mnruecke/currentSensing/PCB_layout.png

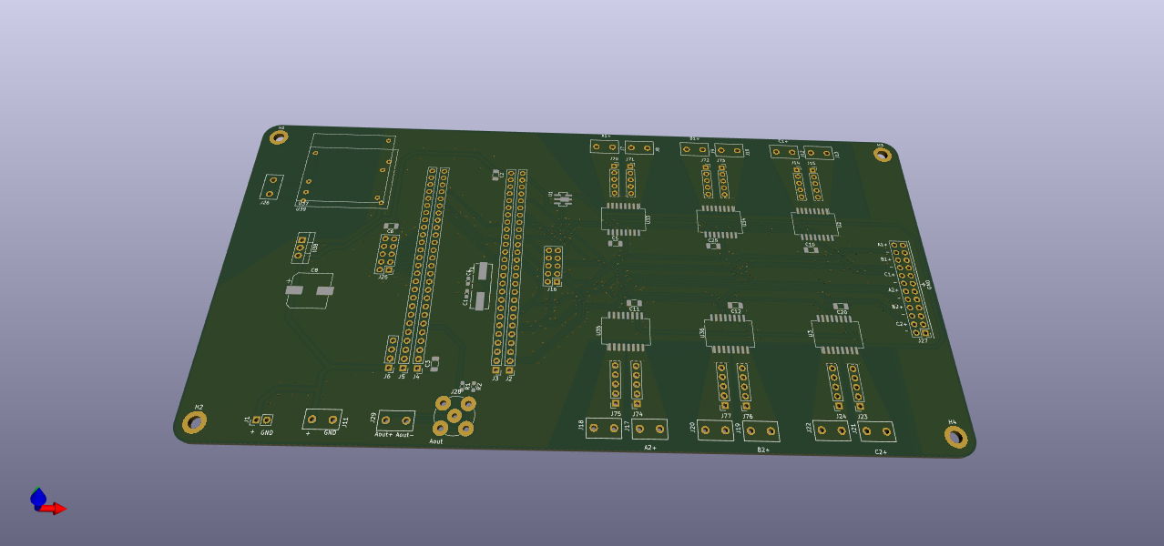
PCB_layout.png
