mnruecke/currentSensing/psoc_directives.png

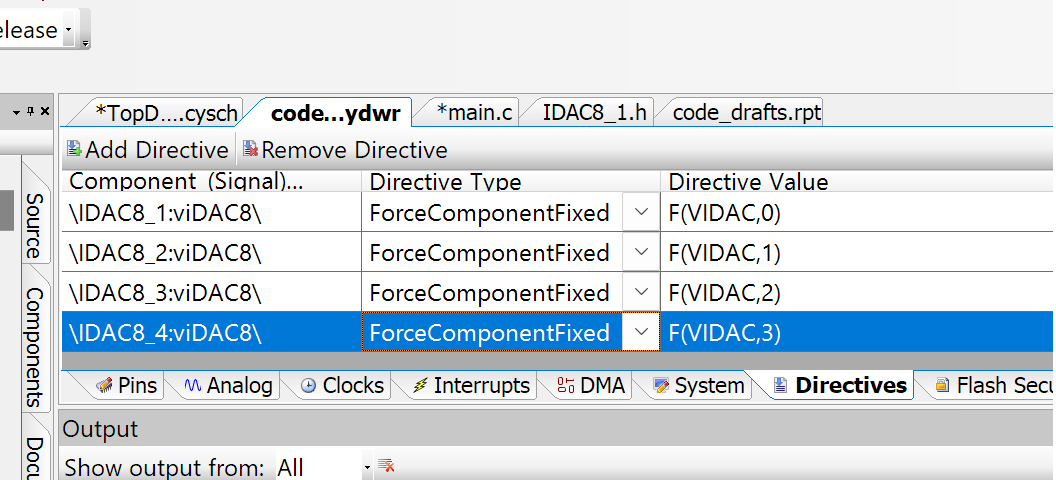
psoc_directives.png
