mnruecke/currentSensing/firmware_schematic_currentSensing_USBFS_ISR.pdf

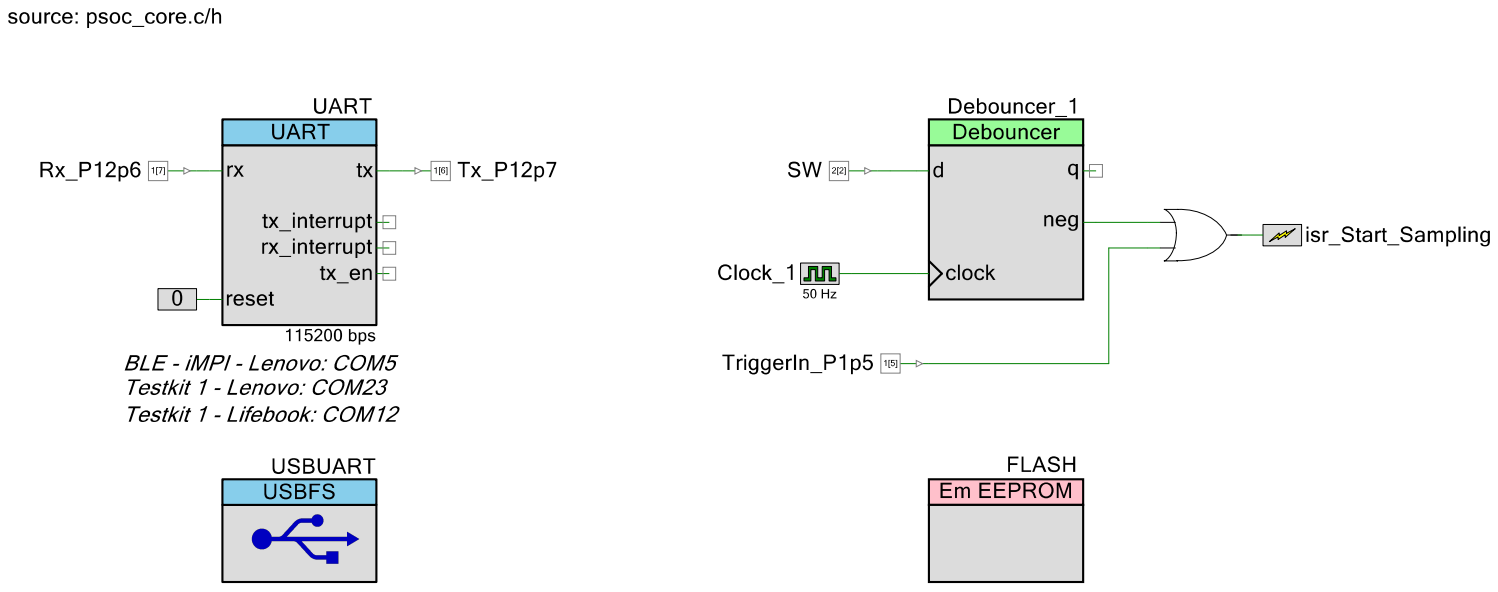
[picture p3: page 2]

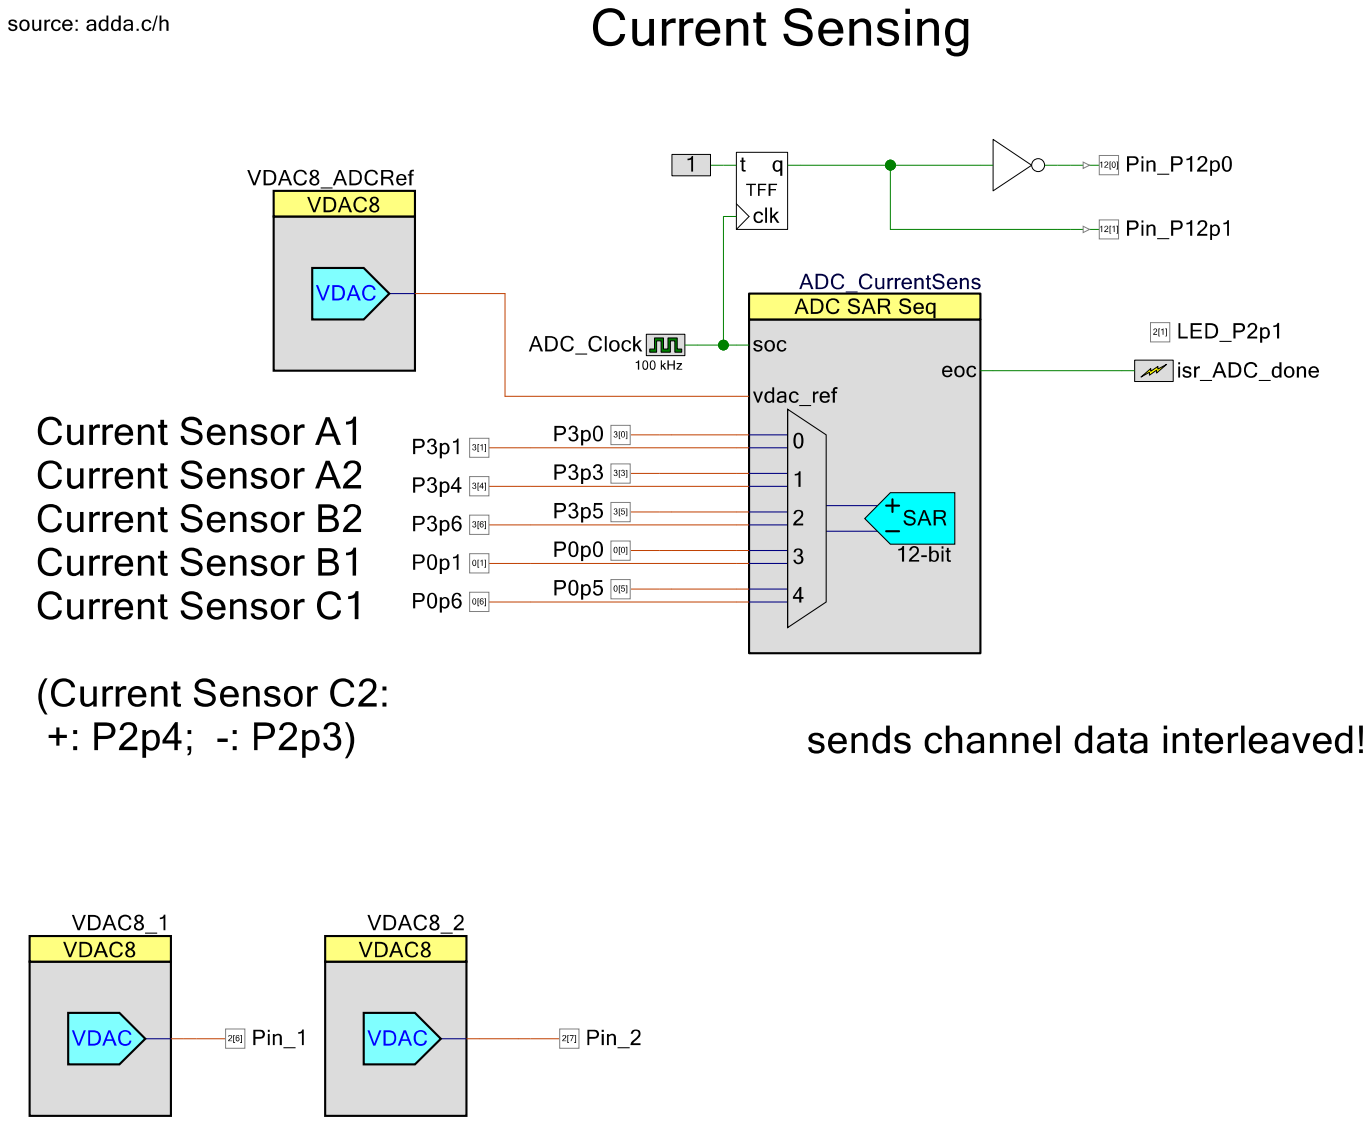
[picture p4: page 3]
