mnruecke/currentSensing/KiCAD_PCB_files/rds_tx.kicad_pcb

## KiCad design KiCAD_PCB_files/rds_tx.kicad_pcb (2023-02-15)

Schematic: rds_tx.kicad_sch, 6CH Current Sensing Module

Parts:
C1, C4: 18p; C_0603_1608Metric_Pad1.08x0.95mm_HandSolder
C2, C3, C5, C6, C10, C11, C12, C20, C25: 100n; C_1206_3216Metric
C8: 100u; CP_Elec_10x12.5
H1, H2, H3, H4: Mounting; MountingHole_3.2mm_M3_DIN965_Pad
J1: LiPo_Akku; PinHeader_1x02_P2.54mm_Vertical
J2: board space lhs; PinHeader_1x26_P2.54mm_Vertical
J3: PSoC lhs; PinHeader_1x26_P2.54mm_Vertical
J4: PSoC rhs; PinHeader_1x26_P2.54mm_Vertical
J5: board space rhs; PinHeader_1x26_P2.54mm_Vertical
J6: BLE; PinHeader_1x04_P2.54mm_Vertical
J7: IP_A1; screw_conn_2
J8: IN_A1; screw_conn_2
J9: IP_B1; screw_conn_2
J10: IN_B1; screw_conn_2
J11: LiPo_Akku; screw_conn_2
J12: IP_C1; screw_conn_2
J13: IN_C1; screw_conn_2
J14: IP_Adjust_C1; PinSocket_1x05_P2.54mm_Vertical
J15: IN_Adjust_C1; PinSocket_1x05_P2.54mm_Vertical
J16: CurrentSensing; PinHeader_2x05_P2.54mm_Vertical
J17: IP_A2; screw_conn_2
J18: IN_A2; screw_conn_2
J19: IP_B2; screw_conn_2
J20: IN_B2; screw_conn_2
J21: IP_C2; screw_conn_2
J22: IN_C2; screw_conn_2
J23: IP_Adjust_C2; PinSocket_1x05_P2.54mm_Vertical
J24: IN_Adjust_C2; PinSocket_1x05_P2.54mm_Vertical
J25: GPIO_Block; PinHeader_2x05_P2.54mm_Vertical
J26: PWR_230V; screw_conn_2
J27: 6CH_Sense; PinHeader_2x12_P2.54mm_Vertical
J28: ACombi; BNC_TEConnectivity_1478204_Vertical
J29: ACombi; screw_conn_2
J70: IP_Adjust_A1; PinSocket_1x05_P2.54mm_Vertical
J71: IN_Adjust_A1; PinSocket_1x05_P2.54mm_Vertical
J72: IP_Adjust_B1; PinSocket_1x05_P2.54mm_Vertical
J73: IN_Adjust_B1; PinSocket_1x05_P2.54mm_Vertical
J74: IP_Adjust_A2; PinSocket_1x05_P2.54mm_Vertical
J75: IN_Adjust_A2; PinSocket_1x05_P2.54mm_Vertical
J76: IP_Adjust_B2; PinSocket_1x05_P2.54mm_Vertical
J77: IN_Adjust_B2; PinSocket_1x05_P2.54mm_Vertical
R1, R2: 0; R_0603_1608Metric_Pad0.98x0.95mm_HandSolder
U1: XC6227; LDO_3p3V_XC6227
U2, U3, U33, U34, U35, U36: MCA1101; SOIC-16W_7.5x12.8mm_P1.27mm
U37: ECE5
U38: L7805; TO-220-3_Vertical
U39: RAC03; ACDC_RAC03
Y1: 18 MHz; ABLS_Crystal_18MHz_SMD

Connections:
+5V: C2.1, C3.1, C6.1, C8.1, J1.1, J2.26, J3.26, J4.1, J5.1, J6.1, J11.1, J16.9, J25.9, U1.1 (CE), U1.4 (VIN), U38.3 (OUT)
/ACL: J26.1, U37.2 (ACL), U39.1 (ACL)
/ACN: J26.2, U37.1 (ACN), U39.4 (ACN)
/Aout+: J4.5, J5.5, J28.1 (In), J29.2
/Aout-: J4.6, J5.6, R1.1
/ISenseN_A1: J2.3, J3.3, J27.22, U33.13 (Vref)
/ISenseN_A2: J2.6, J3.6, J27.10, U35.13 (Vref)
/ISenseN_B1: J2.8, J3.8, J27.18, U34.13 (Vref)
/ISenseN_B2: J2.17, J3.17, J27.6, U36.13 (Vref)
/ISenseN_C1: J2.22, J3.22, J27.14, U2.13 (Vref)
/ISenseN_C2: J4.23, J5.23, J27.2, U3.13 (Vref)
/ISenseP_A1: J2.2, J3.2, J16.3, J27.24, U33.12 (Vout)
/ISenseP_A2: J2.5, J3.5, J16.4, J27.12, U35.12 (Vout)
/ISenseP_B1: J2.7, J3.7, J16.5, J27.20, U34.12 (Vout)
/ISenseP_B2: J2.16, J3.16, J16.6, J27.8, U36.12 (Vout)
/ISenseP_C1: J2.21, J3.21, J16.7, J27.16, U2.12 (Vout)
/ISenseP_C2: J4.22, J5.22, J16.8, J27.4, U3.12 (Vout)
/P12.0: J4.11, J5.11, J25.1
/P12.1: J4.12, J5.12, J25.2
/P12.2: J4.13, J5.13, J25.3
/P12.3: J4.14, J5.14, J25.4
/P12.4: J4.15, J5.15, J25.5
/P12.5: J4.16, J5.16, J25.6
/P12.6: J4.17, J5.17, J25.7
/P12.7: J4.18, J5.18, J25.8
/XTALn: C1.2, J2.10, J3.10, Y1.2
/XTALp: C4.1, J2.11, J3.11, Y1.1
/senseA1+: J7.1, J7.2, J70.1, J70.2, J70.3, J70.4, J70.5, U33.5 (IP-), U33.6 (IP-), U33.7 (IP-), U33.8 (IP-)
/senseA1-: J8.1, J8.2, J71.1, J71.2, J71.3, J71.4, J71.5, U33.1 (IP+), U33.2 (IP+), U33.3 (IP+), U33.4 (IP+)
/senseA2+: J17.1, J17.2, J74.1, J74.2, J74.3, J74.4, J74.5, U35.5 (IP-), U35.6 (IP-), U35.7 (IP-), U35.8 (IP-)
/senseA2-: J18.1, J18.2, J75.1, J75.2, J75.3, J75.4, J75.5, U35.1 (IP+), U35.2 (IP+), U35.3 (IP+), U35.4 (IP+)
/senseB1+: J9.1, J9.2, J72.1, J72.2, J72.3, J72.4, J72.5, U34.5 (IP-), U34.6 (IP-), U34.7 (IP-), U34.8 (IP-)
/senseB1-: J10.1, J10.2, J73.1, J73.2, J73.3, J73.4, J73.5, U34.1 (IP+), U34.2 (IP+), U34.3 (IP+), U34.4 (IP+)
/senseB2+: J19.1, J19.2, J76.1, J76.2, J76.3, J76.4, J76.5, U36.5 (IP-), U36.6 (IP-), U36.7 (IP-), U36.8 (IP-)
/senseB2-: J20.1, J20.2, J77.1, J77.2, J77.3, J77.4, J77.5, U36.1 (IP+), U36.2 (IP+), U36.3 (IP+), U36.4 (IP+)
/senseC1+: J12.1, J12.2, J14.1, J14.2, J14.3, J14.4, J14.5, U2.5 (IP-), U2.6 (IP-), U2.7 (IP-), U2.8 (IP-)
/senseC1-: J13.1, J13.2, J15.1, J15.2, J15.3, J15.4, J15.5, U2.1 (IP+), U2.2 (IP+), U2.3 (IP+), U2.4 (IP+)
/senseC2+: J21.1, J21.2, J23.1, J23.2, J23.3, J23.4, J23.5, U3.5 (IP-), U3.6 (IP-), U3.7 (IP-), U3.8 (IP-)
/senseC2-: J22.1, J22.2, J24.1, J24.2, J24.3, J24.4, J24.5, U3.1 (IP+), U3.2 (IP+), U3.3 (IP+), U3.4 (IP+)
/sig1: J4.20, J5.20, J16.1
/sig2: J4.21, J5.21, J16.2
GND: C1.1, C2.2, C3.2, C4.2, C5.2, C6.2, C8.2, C10.2, C11.2, C12.2, C20.2, C25.2, H2.1, H3.1, H4.1, J1.2, J2.1, J2.25, J3.1, J3.25, J4.2, J5.2, J6.2, J11.2, J16.10, J25.10, J27.1, J27.3, J27.5, J27.7, J27.9, J27.11, J27.13, J27.15, J27.17, J27.19, J27.21, J27.23, R2.1, U1.2 (VSS), U2.11 (GND), U2.14 (GND), U2.15 (GND), U3.11 (GND), U3.14 (GND), U3.15 (GND), U33.11 (GND), U33.14 (GND), U33.15 (GND), U34.11 (GND), U34.14 (GND), U34.15 (GND), U35.11 (GND), U35.14 (GND), U35.15 (GND), U36.11 (GND), U36.14 (GND), U36.15 (GND), U37.4 (Vout-), U38.2 (GND), U39.2 (-Vout)
unnamed: J2.4, J3.4
unnamed: J2.9, J3.9
unnamed: J2.12, J3.12
unnamed: J2.13, J3.13
unnamed: J2.14, J3.14
unnamed: J2.15, J3.15
unnamed: J2.18, J3.18
unnamed: J2.19, J3.19
unnamed: J2.20, J3.20
unnamed: J2.23, J3.23
unnamed: J2.24, J3.24
unnamed: J4.3, J5.3, J6.3
unnamed: J4.4, J5.4, J6.4
unnamed: J4.7, J5.7
unnamed: J4.8, J5.8
unnamed: J4.9, J5.9
unnamed: J4.10, J5.10
unnamed: J4.19, J5.19
unnamed: J4.24, J5.24
unnamed: J4.25, J5.25
unnamed: J4.26, J5.26
unnamed: J28.2 (Ext), J29.1, R1.2, R2.2
unnamed: U37.5 (Vout+), U38.1 (IN), U39.3 (+Vout)

Notes on the sheet:
3.6
1.0
3.2
VDD
12.7
GND
PSoC, BLE
15.1
RST
0.4
1.4
2.0
3.7
Connectors
0.3
15.0
3.0
1.3
6x MCA1101
1.6
15.5
12.0
0.1
0.5
15.4
15.2
1.1
2.2
1.7
2.1
20,32 mm
0.7
0.6
LED
1.5
Power
15.3
0.2
1.2
3.4
0.0
PSoC
2.7
3.5
3.3

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
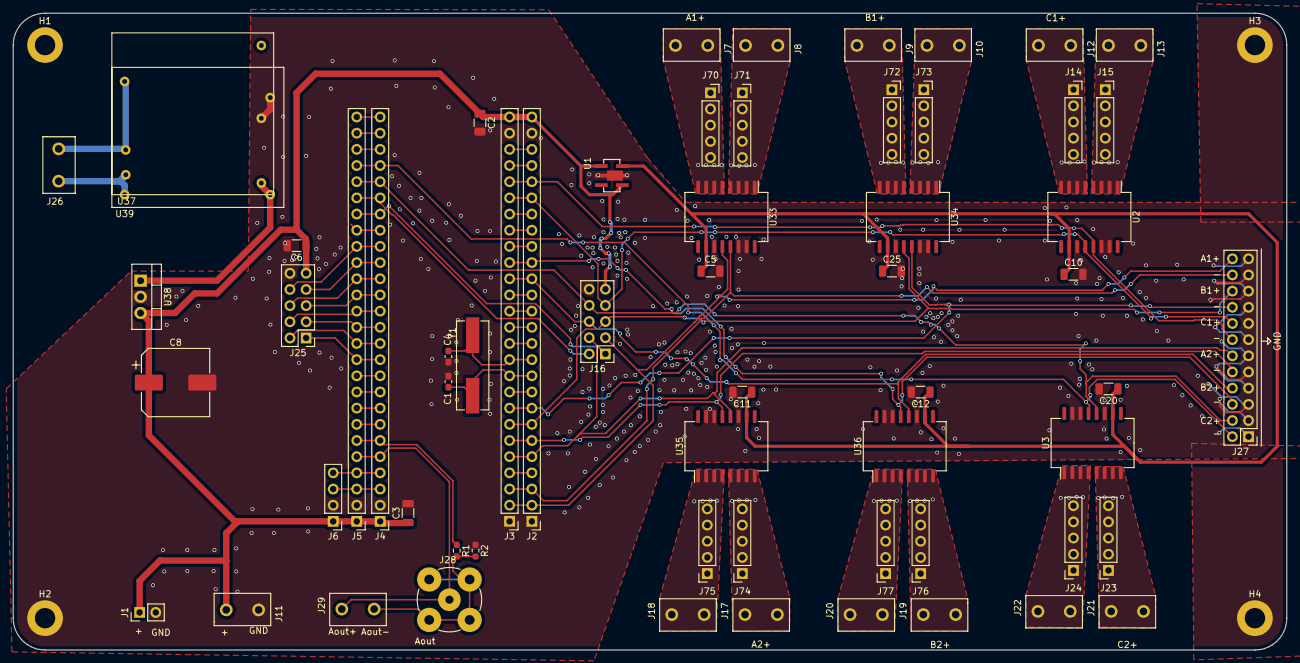
[picture p5: board rds_tx.kicad_pcb from above]

Board: 2 copper layers, 200.0 x 100.0 mm, 66 parts (0 on the bottom side), 66 nets.
