mnruecke/currentSensing/(commit log)

2023-02-02 currentSensing 20230202
2023-02-02 modified *.py script, switched from DMA to ISR version
2023-02-03 currentSens. ISR -> HC05 module + ext. 18 MHz Osz
2023-02-03 fix var collision with 'time' var
    [current_sensing_readout.py]
2023-02-03 add pdf with firmware schematic for the ISR version
2023-02-03 add uart command 'h' for sending only first 60 bytes
2023-02-04 switch back to 115200 Baud (ISR version)
2023-02-04 calibrate adc readout in *.py script
2023-02-05 add analog trigger input (ISR version) for triggering of current signals
2023-02-07 add KiCAD PCB files to repo
    [rds_tx.kicad_pcb, rds_tx.kicad_sch, rds_tx.sch]
2023-02-15 minor corrections in 32bit DAC access example
    [main.c]
2023-03-07 start DMA version with 2Ms total
